climatex/KeybJr/README.md

# KeybJr
Use any PS/2, AT or XT keyboard with the IBM PCjr, over the infrared or cable.

# More information
Check out my [website article](http://boginjr.com/it/hw/keybjr) to learn more!
