climatex/KeybJr/Board/KeybJr.kicad_sch.png

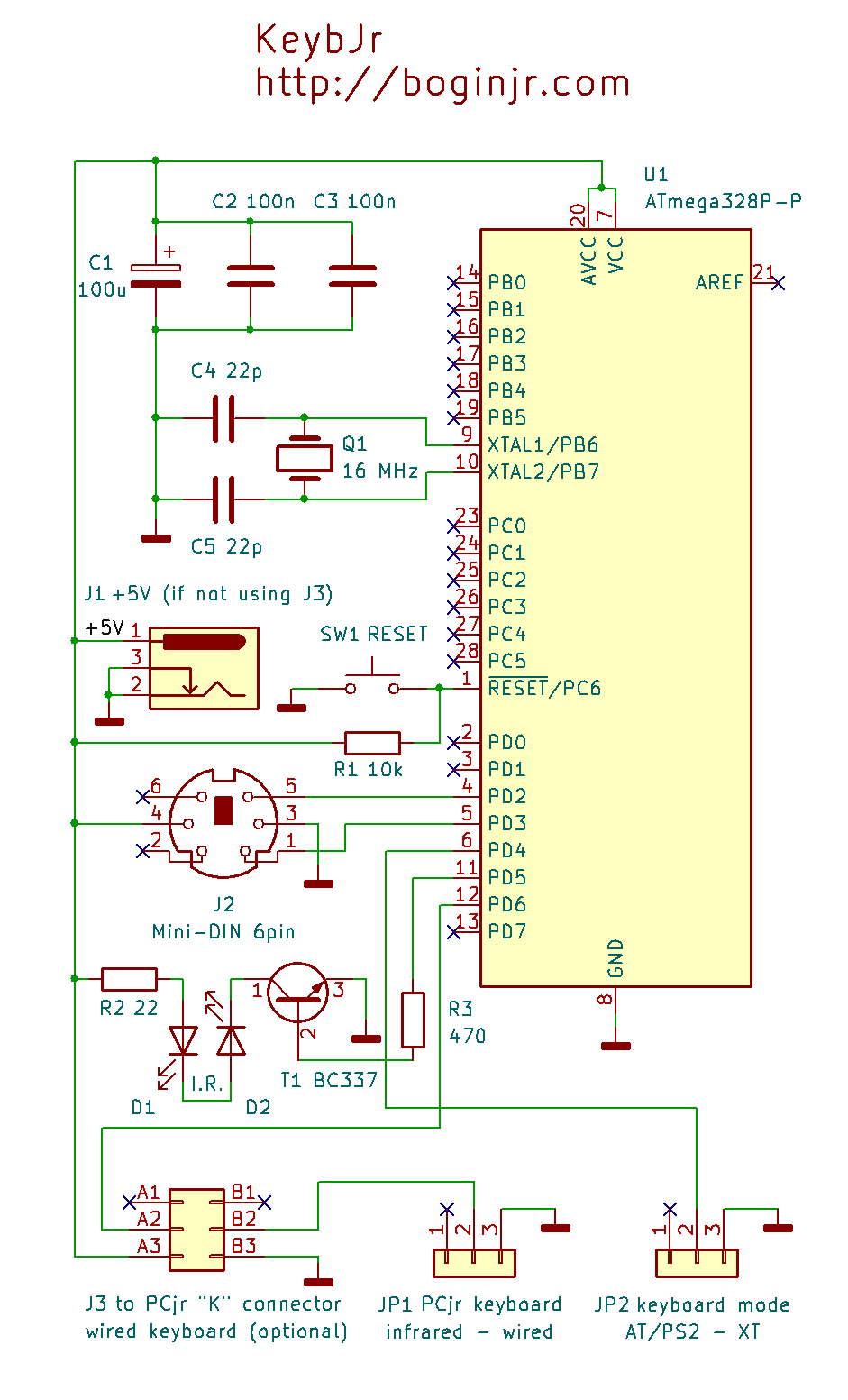
Board/KeybJr.kicad_sch.png
