climatex/KeybJr/Board/KeybJr.kicad_pcb

## KiCad design Board/KeybJr.kicad_pcb (2024-10-25)

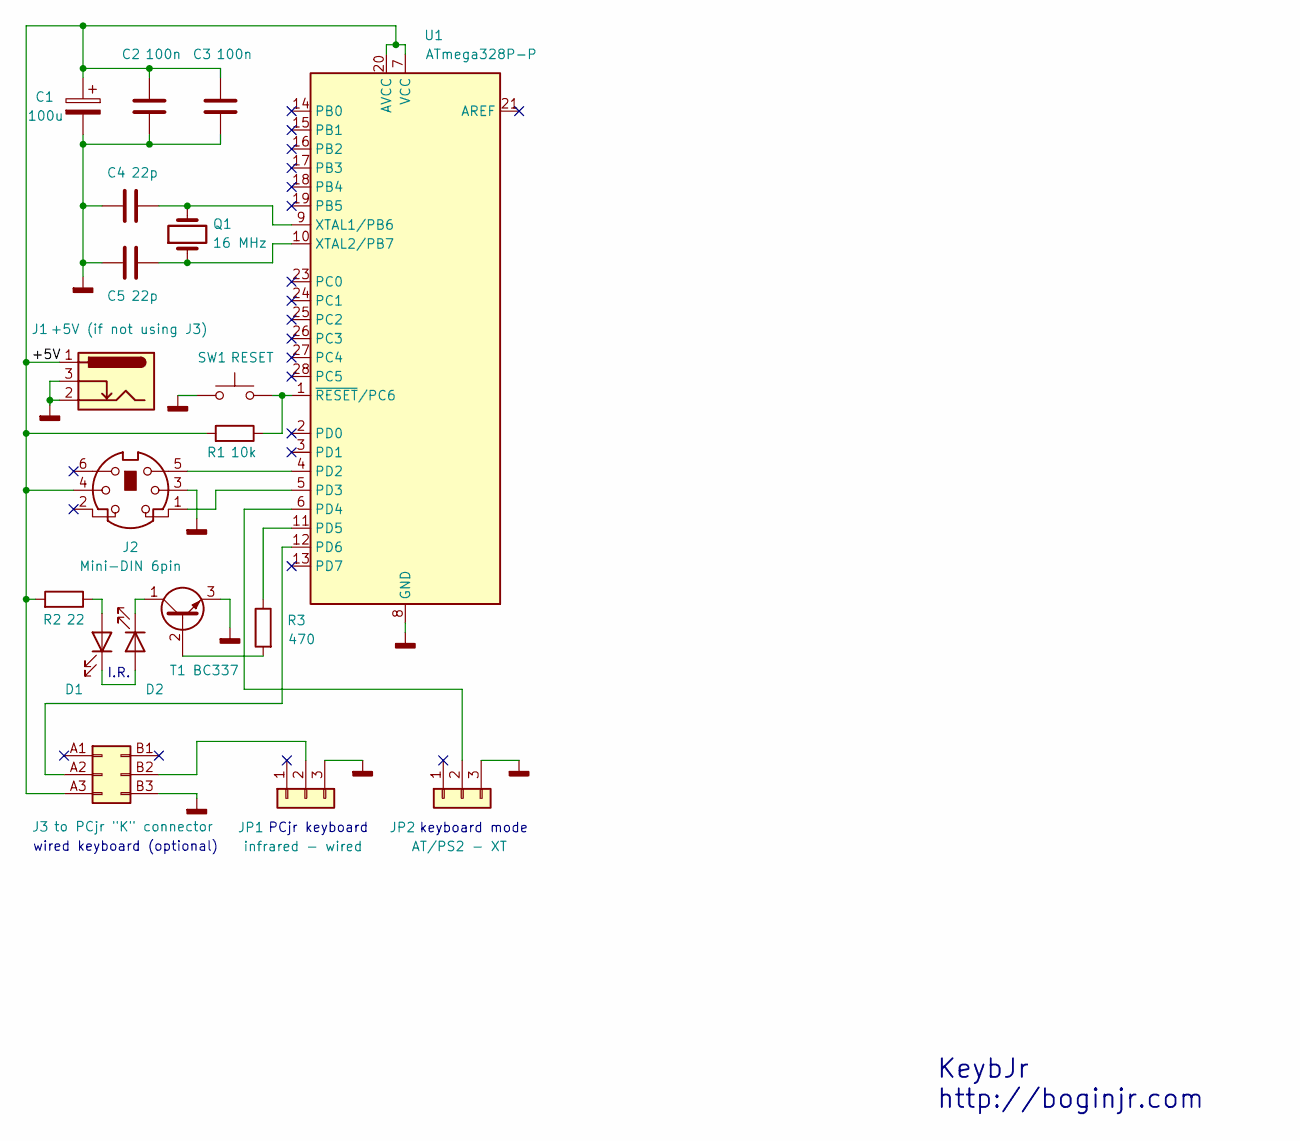
[picture p2: schematic KeybJr.kicad_sch]

Parts:
C1: 100u; CP_Radial_D6.3mm_P2.50mm
C2, C3: 100n; C_Disc_D7.5mm_W2.5mm_P5.00mm
C4, C5: 22p; C_Disc_D7.5mm_W2.5mm_P5.00mm
D1, D2: LED; LED_D5.0mm_IRGrey
J1: +5V (if not using J3); BarrelJack_Horizontal
J2: Mini-DIN 6pin; Mini_DIN6_Female_THT
J3: to PCjr "K" connector; PinHeader_2x03_P2.54mm_Vertical
JP1: infrared - wired; PinHeader_1x03_P2.54mm_Vertical
JP2: AT/PS2 - XT; PinHeader_1x03_P2.54mm_Vertical
Q1: 16 MHz; Crystal_HC49-U_Vertical
R1: 10k; R_Axial_DIN0207_L6.3mm_D2.5mm_P10.16mm_Horizontal
R2: 22; R_Axial_DIN0207_L6.3mm_D2.5mm_P10.16mm_Horizontal
R3: 470; R_Axial_DIN0207_L6.3mm_D2.5mm_P10.16mm_Horizontal
SW1: RESET; SW_PUSH_6mm
T1: BC337; TO-92_Inline
U1: ATmega328P-P; DIP-28_W7.62mm

Connections:
/+5V: C1.1, C2.1, C3.1, J1.1, J2.4, J3.A3 (Pin_a3), R1.2, R2.2, U1.7 (VCC), U1.20 (AVCC)
GNDD: C1.2, C2.2, C3.2, C4.1, C5.1, J1.2, J1.3, J2.3, J2.SH1, J2.SH2, J2.SH3, J3.B3 (Pin_b3), JP1.3, JP2.3, SW1.2, T1.3 (E), U1.8 (GND), U1.22 (GND)
unnamed: D1.2 (A), R2.1
unnamed: D1.1 (K), D2.2 (A)
unnamed: D2.1 (K), T1.1 (C)
unnamed: J3.A2 (Pin_a2), U1.12 (PD6)
unnamed: J3.B2 (Pin_b2), JP1.2
unnamed: JP2.2, U1.6 (PD4)
unnamed: R3.2, T1.2 (B)
unnamed: J2.5, U1.4 (PD2)
unnamed: J2.1, U1.5 (PD3)
unnamed: R3.1, U1.11 (PD5)
unnamed: C4.2, Q1.2, U1.9 (XTAL1/PB6)
unnamed: C5.2, Q1.1, U1.10 (XTAL2/PB7)
unnamed: R1.1, SW1.1, U1.1 (~RESET/PC6)

Notes on the sheet:
wired keyboard (optional)
KeybJr http://boginjr.com
keyboard mode
PCjr keyboard
I.R.

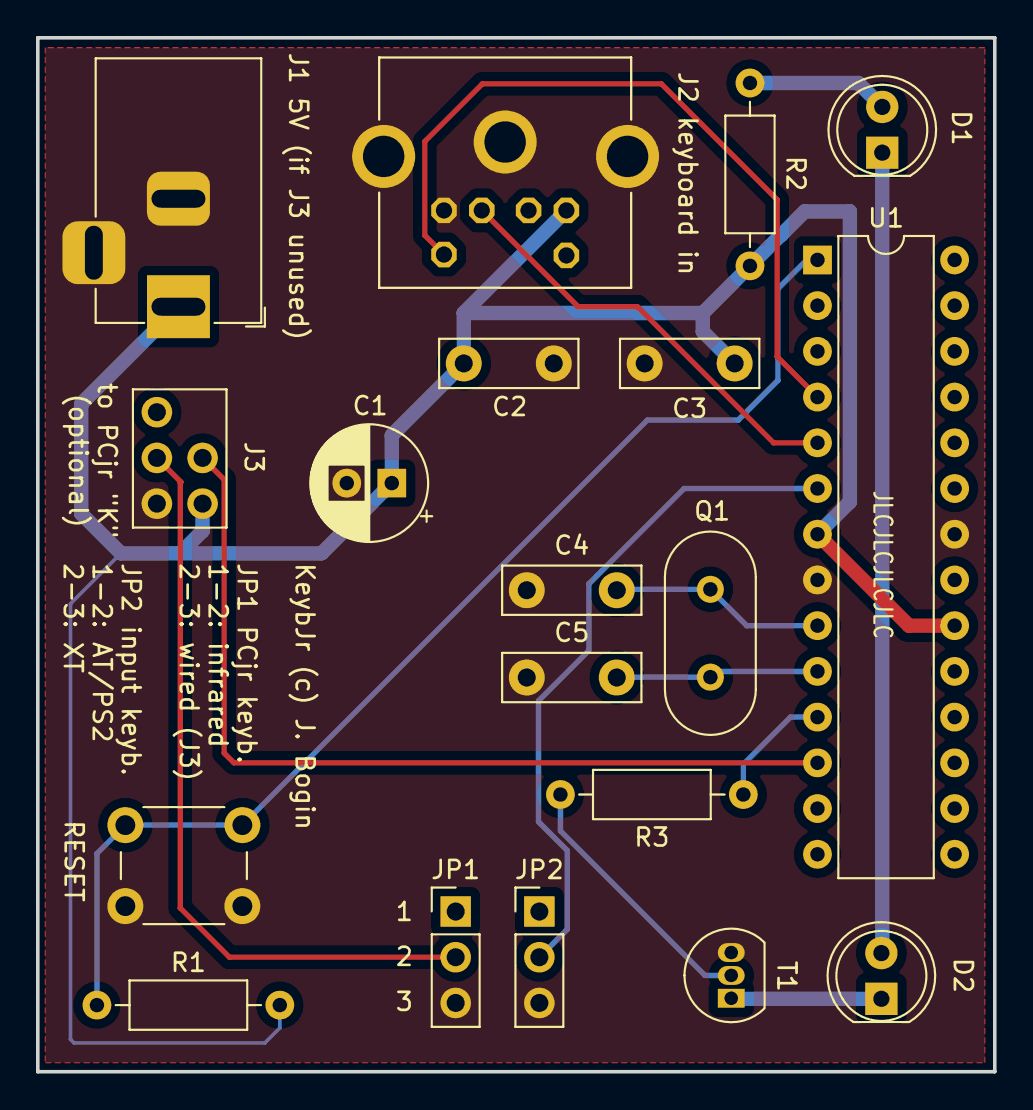
[picture p3: board KeybJr.kicad_pcb from above]

Board: 2 copper layers, 53.2 x 57.4 mm, 19 parts (0 on the bottom side), 15 nets.
