climatex/KeybJr/(commit log)

2022-04-07 Implement XT keyboard reset
    [KeybJr.cpp]
2024-10-25 Add board PCB, bugfixes
    [KeybJr-B_Cu.gbl, KeybJr-B_Mask.gbs, KeybJr-B_Paste.gbp, KeybJr-B_Silkscreen.gbo, KeybJr-Edge_Cuts.gm1, KeybJr-F_Cu.gtl, KeybJr-F_Mask.gts, KeybJr-F_Paste.gtp]
